aram-ap/daredevil/hardware/models/Wrist Module/Wrist Module Enclosure.3mf

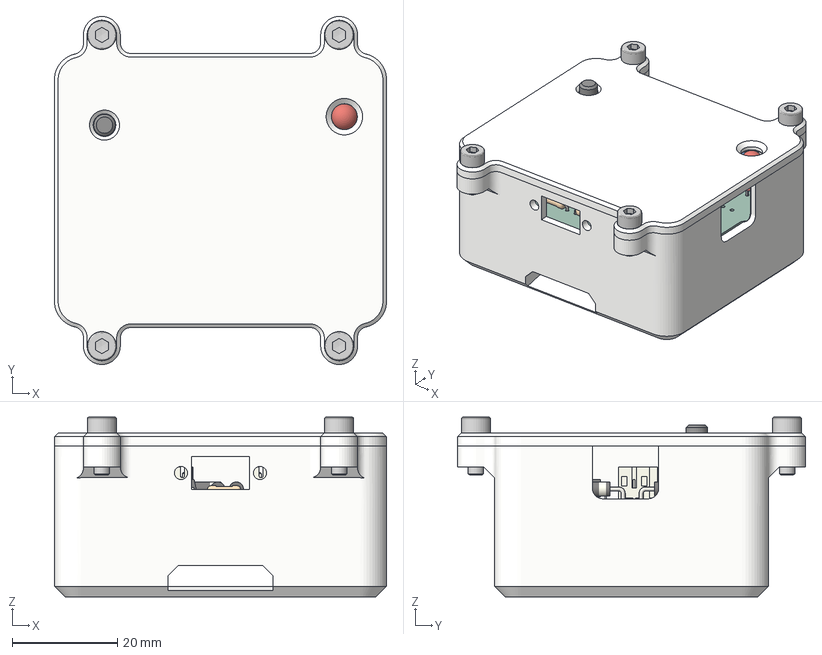
[picture p3: CAD file, 2026-11-05]
hardware/models/Wrist Module/Wrist Module Enclosure.3mf
63.0 x 66.0 x 34.1 mm
