aram-ap/daredevil/(list of files, cad)

Other CAD files:
hardware/models/Wrist Module/Wrist_Module_Enclosure.f3z
