aram-ap/daredevil/hardware/wrist_module/Prints/wrist_module.pdf

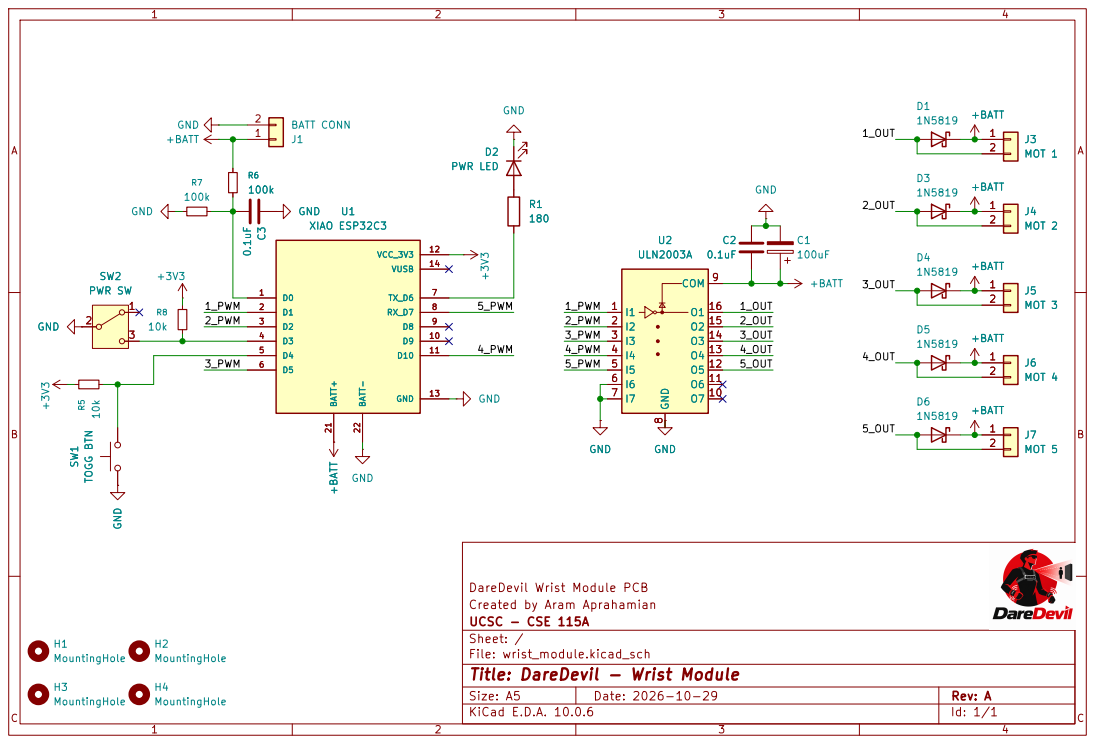
[picture p4: page 1]

SW2 PWR SW SW1 TOGG BTN

2 +BATT GND SW1 TOGG BTN SW2 PWR SW

DareDevil Wrist Module PCB
Created by Aram Aprahamian
UCSC - CSE 115A
Sheet: /
File: wrist_module.kicad_sch
Title: DareDevil - Wrist Module

Size: A5 | Rev: A | C Date: 2026-10-29
KiCad E.D.A. 10.0.6 | Id: 1/1
