aram-ap/daredevil/hardware/wrist_module/wrist_module.kicad_pcb

## KiCad design hardware/wrist_module/wrist_module.kicad_pcb (2026-11-03)

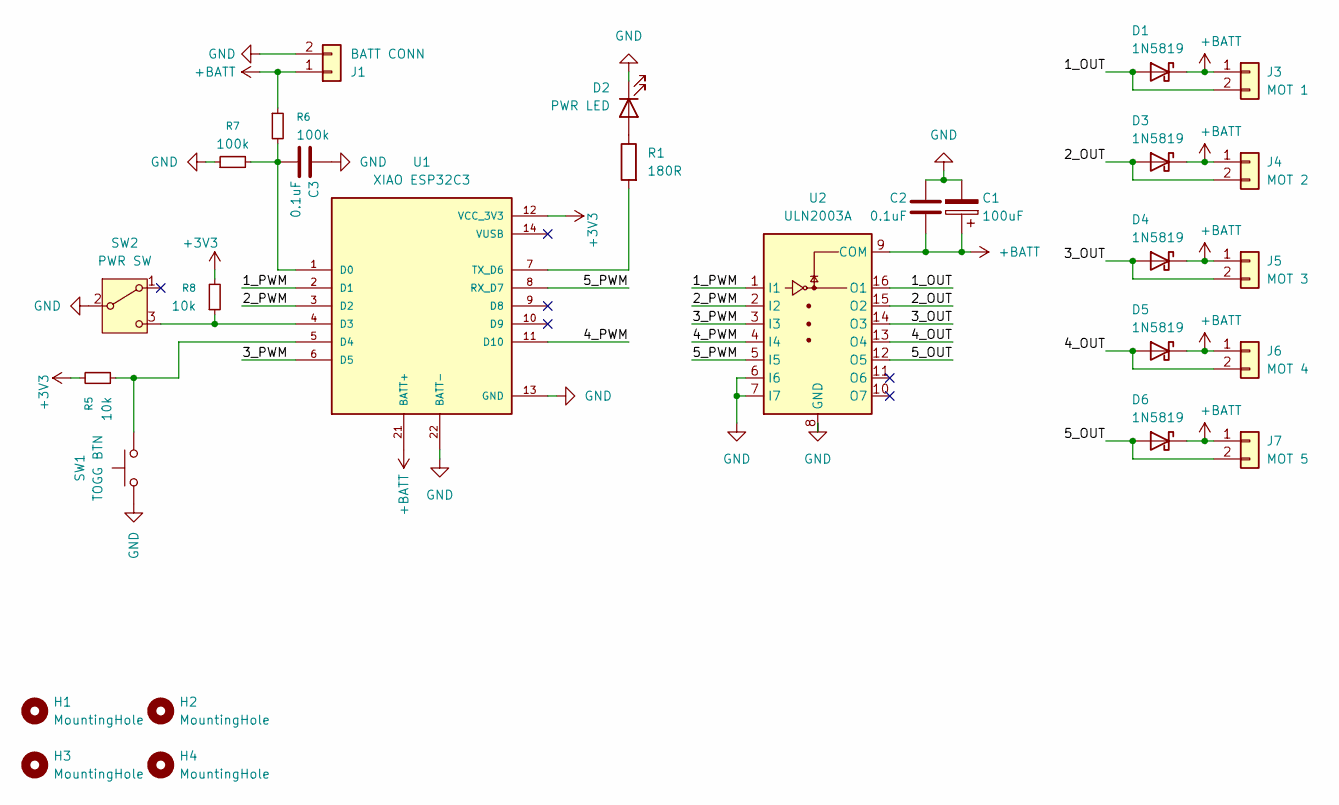
[picture p5: schematic wrist_module.kicad_sch, DareDevil - Wrist Module]

Parts:
C1: 100uF; CP_Radial_D8.0mm_P2.50mm
C2, C3: 0.1uF; C_Disc_D3.8mm_W2.6mm_P2.50mm
D1, D3, D4, D5, D6: 1N5819; D_DO-41_SOD81_P10.16mm_Horizontal
D2: PWR LED; LED_D5.0mm
H1, H2, H3, H4: MountingHole; MountingHole_2.2mm_M2_ISO7380
J1: BATT CONN; JST_PH_B2B-PH-K_1x02_P2.00mm_Vertical
J3: MOT 1; JST_PH_B2B-PH-K_1x02_P2.00mm_Vertical
J4: MOT 2; JST_PH_B2B-PH-K_1x02_P2.00mm_Vertical
J5: MOT 3; JST_PH_B2B-PH-K_1x02_P2.00mm_Vertical
J6: MOT 4; JST_PH_B2B-PH-K_1x02_P2.00mm_Vertical
J7: MOT 5; JST_PH_B2B-PH-K_1x02_P2.00mm_Vertical
R1: 180R; R_Axial_DIN0207_L6.3mm_D2.5mm_P7.62mm_Horizontal
R5, R8: 10k; R_Axial_DIN0207_L6.3mm_D2.5mm_P7.62mm_Horizontal
R6, R7: 100k; R_Axial_DIN0207_L6.3mm_D2.5mm_P7.62mm_Horizontal
SW1: TOGG BTN; SW_PUSH_6mm
SW2: PWR SW; JST_PH_B3B-PH-K_1x03_P2.00mm_Vertical
U1: XIAO ESP32C3; XIAO-ESP32-C3-DIP-SMD; PARTREV 23/05/2022
U2: ULN2003A; DIP-16_W7.62mm_LongPads

Connections:
+3V3: R5.2, R8.2, U1.12 (VCC_3V3)
+BATT: C1.1, C2.2, D1.1 (K), D3.1 (K), D4.1 (K), D5.1 (K), D6.1 (K), J1.1, J3.1, J4.1, J5.1, J6.1, J7.1, R6.1, U1.21 (BATT+), U2.9 (COM); also elsewhere on the board
/1_OUT: D1.2 (A), J3.2, U2.16 (O1)
/1_PWM: U1.2 (D1), U2.1 (I1)
/2_OUT: D3.2 (A), J4.2, U2.15 (O2)
/2_PWM: U1.3 (D2), U2.2 (I2)
/3_OUT: D4.2 (A), J5.2, U2.14 (O3)
/3_PWM: U1.6 (D5), U2.3 (I3)
/4_OUT: D5.2 (A), J6.2, U2.13 (O4)
/4_PWM: U1.11 (D10), U2.4 (I4)
/5_OUT: D6.2 (A), J7.2, U2.12 (O5)
/5_PWM: U1.8 (RX_D7), U2.5 (I5)
GND: C1.2, C2.1, C3.1, D2.1 (K), J1.2, R7.1, SW1.2, SW2.2 (B), U1.13 (GND), U1.22 (BATT-), U2.6 (I6), U2.7 (I7), U2.8 (GND); also elsewhere on the board
unnamed: D2.2 (A), R1.1
unnamed: R8.1, SW2.3 (C), U1.4 (D3)
unnamed: C3.2, R6.2, R7.2, U1.1 (D0)
unnamed: R5.1, SW1.1, U1.5 (D4)
unnamed: R1.2, U1.7 (TX_D6)

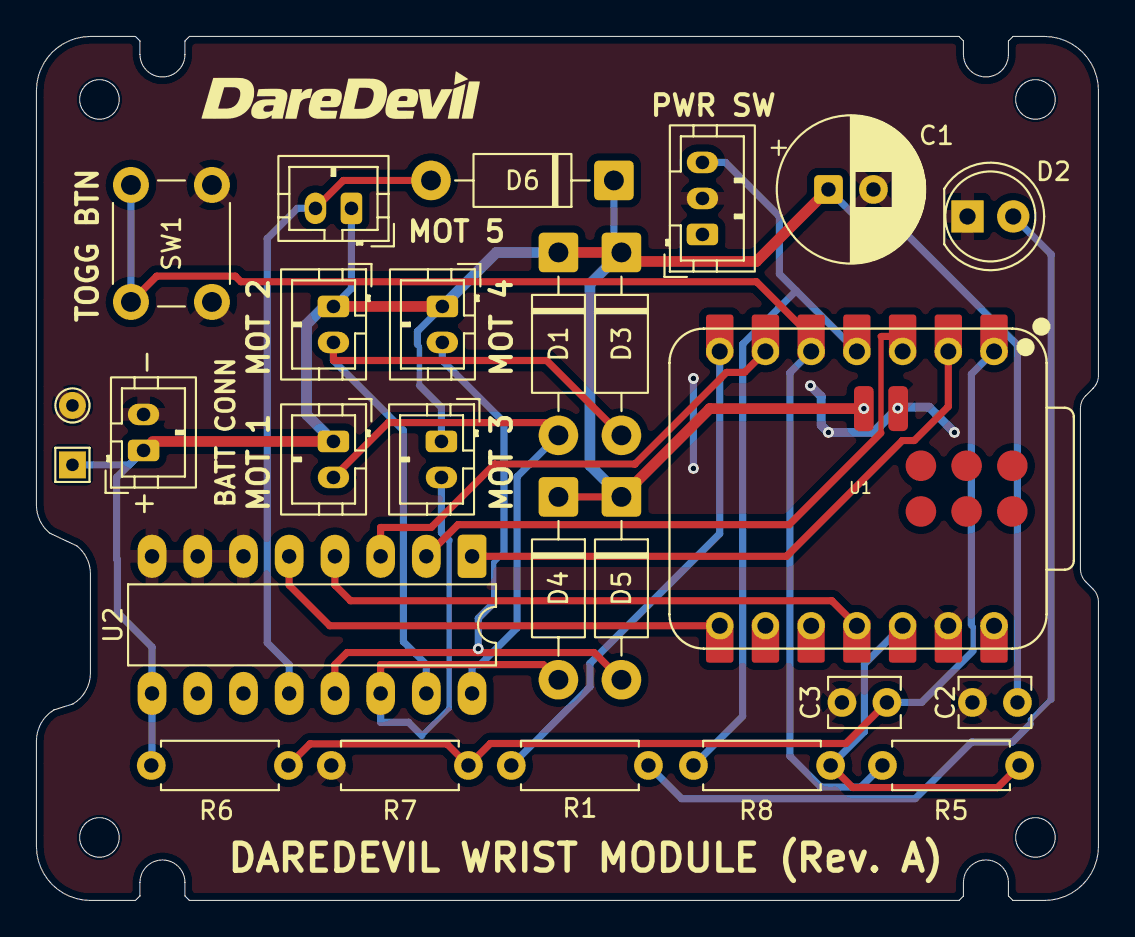
[picture p6: board wrist_module.kicad_pcb from above]

Board: 2 copper layers, 59.0 x 48.0 mm, 30 parts (0 on the bottom side), 18 nets.

Other parts of the board:
T1: TestPoint_THTPad_1.5x1.5mm_Drill0.7mm
T2: TestPoint_THTPad_D1.5mm_Drill0.7mm

Their connections:
+BATT: T1.1; also elsewhere on the board
GND: T2.1; also elsewhere on the board
