aram-ap/daredevil/hardware/wrist_module/Prints/wrist_module_back.png

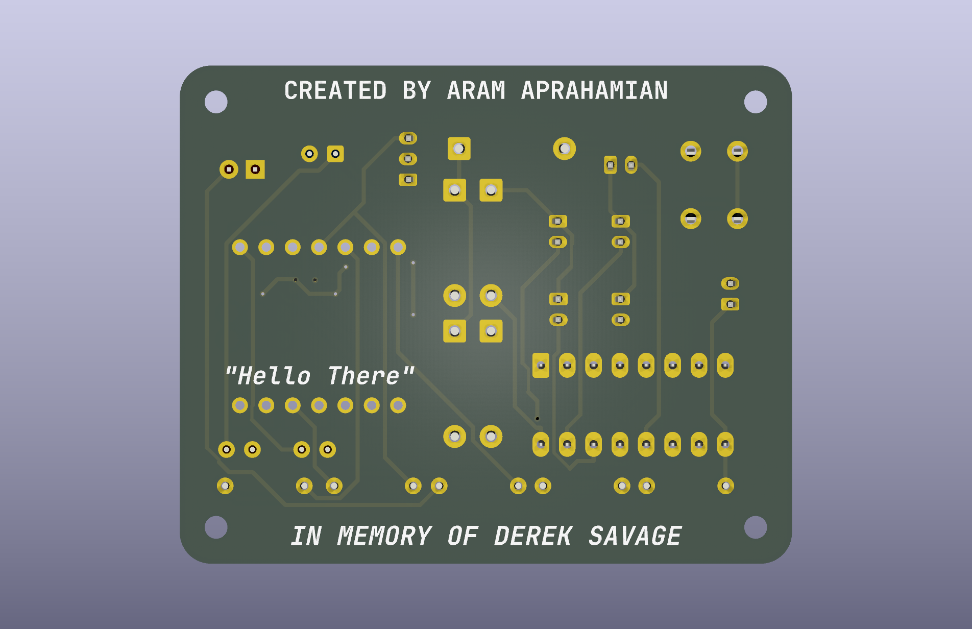
hardware/wrist_module/Prints/wrist_module_back.png
