aram-ap/daredevil/(commit log)

2026-10-20 Add realsense single frame depth capture script (test on hardware)
2026-10-21 Add multi frame capture, CLI, CSV output
2026-10-22 Add Jetson-ESP32 serial link. Development state progress: 30%
2026-10-22 Added schematcs for the wrist modules
    Contains the parts library, Kicad project, and schematics
2026-10-29 Update wrist module schematic and PCB, add hardware README
2026-10-29 Adjustments to Schematics and PCB Layout to Showcase DareDevil Logo
    Added the DareDevil Logo to the Schematic, improved the location of the
    DareDevil logo on the PCB, re-exported images to reflect changes
2026-10-29 Added traces to PCB, updated READMEs
    Successfully routed all traces, added GND netting, closer to
    manufacturing.
2026-10-29 Added Battery Test Points
2026-11-03 Final Adjustments
    Included notches, improved logo/text placement, trace width changes, and
    final parts placement
2026-11-04 tests for esp32
2026-11-04 Additional code that deals with the connection between esp32 and jetson
2026-11-05 depth-zones: add IMU pitch estimator
    Claude-Session: https://claude.ai/code/session_01Eya1XMpPqXUp2WM3jwJjpz
2026-11-05 depth-zones: add floor and hands/cane filtering with per-zone distances
    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
2026-11-05 depth-zones: add zone-to-motor mapper and link contract test (task 6.7)
    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
2026-11-05 Add depth-heatmap-live: live depth heatmap over an SSH tunnel for visual testing
    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
2026-11-05 depth-heatmap-live: document design and add docstrings/comments
    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
2026-11-05 feature: Flask Web Server with live camera view
2026-11-05 refactor: serves single-framed jpeg
2026-11-05 fix: Only logs when >= 1 Object in frame
2026-11-05 Update README with CLI usage, CSV columns and results table
    Replace the Usage TODO with the real collect_depth.py options and output,
    document the CSV columns, bring the status checklist in line with the code,
    and add an empty results table for the 0.5/1/2/3 m accuracy test.
    Docs only; the camera script is still unverified on the Jetson.
    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
2026-11-11 Add event vibration patterns and battery monitor with tests
